vecvedant/Physical-AI-Challange/docs/report/Udyog_IQ_Project_Report.docx

ARDUINO PHYSICAL AI CHALLENGE INDIA 2026

Project Report

UDYOG IQ

Edge AI energy intelligence for small industry. One meter, one board, no cloud.

Project Title | Udyog IQ: Edge AI Energy Intelligence for Small Industry
Team Name | enter your registered team name
Registration / Team ID | enter your portal team ID
Contest Track | Industrial and Sustainability AI
Institution & City | enter your institution and city

## Team Members

Role | Name | Email
Team Leader | Vedant Charegaonkar | vec.vedant@gmail.com
Member 2 (optional)
Member 3 (optional)
Member 4 (optional)

In one sentence

A small factory has a dozen machines, one electricity connection, and a bill nobody understands. Udyog IQ puts a single energy meter on the incoming supply and an Arduino UNO Q beside it, and works out by itself, with no labelled training data, which machines are running, which one is starting to fail, how much money is being burned on idle, and when to use solar, battery or grid so the plant pays less.

# 1. Project Overview

## Problem Statement

India has millions of MSME workshops: machine shops, textile units, cold stores, small fabricators. Each runs a handful of motors on one electricity connection and receives a bill it cannot explain, because metering every machine costs more than the electricity it would save. Two large costs therefore go unmanaged. Utilities bill the highest average demand in any half hour of the month, priced per kVA, so one careless half hour where several motors start together sets a charge paid every month afterwards. Separately, compressors and pumps fail without warning even though their electrical signature had been drifting for weeks, because nobody was watching it.

## How Your Project Works

A single Selec EM2M energy meter sits on the incoming supply and is read over RS485 Modbus by the Arduino UNO Q. The STM32 microcontroller masters the bus at 1 Hz and drives a contactor behind a hardware interlock. The Qualcomm processor, running Debian, does everything else on the board.

Every time a machine switches on or off it leaves a step in real and reactive power. The node clusters those step signatures and recovers the individual machines from the aggregate, so one meter serves the whole workshop. Each machine's start events are then scored against a model of its own learned normal, which flags degradation before failure. In parallel the node forecasts plant load from its own history and solar generation from a weather feed, then solves a 24 hour battery schedule against time of day tariffs every fifteen minutes. Idle machines are cut, demand peaks are shaved before they are set, and a shadow ledger records what the same day would have cost without the device. Everything runs on the board, and a dashboard is served from it over the local network.

## Why Arduino UNO Q?

This project needs two different kinds of computer at once, and the UNO Q is one board that is both.

Brain | What it runs | Why it must be this one
STM32U585 Cortex-M33 | Modbus RTU master, contactor interlock, watchdog | RS485 has a turnaround deadline. The driver must release the line within a character time of the last stop bit or the reply collides with our own echo. Linux meets that deadline almost always, and almost means a corrupt frame every few minutes that looks exactly like a wiring fault.
Qualcomm QRB2210 quad Cortex-A53, Debian | Disaggregation, anomaly detection, forecasting, dispatch optimiser, historian, dashboard | scikit-learn, a SQLite historian, a 96 step optimisation recomputed every 15 minutes, and a web server. This is not microcontroller work.

The division also matters for safety. Minimum contactor dwell times and the switching rate cap are enforced on the microcontroller, so they hold even when the Linux side hangs, fills its disk, or is being updated. The Python policy engine checks the same rules first, but only so that it does not issue requests which would be refused. It is not the safety mechanism.

The honest version of this claim

An ESP32 could read the meter but could not run the learning half. A Raspberry Pi could run the learning half but could not promise the real time half. Using both would mean two boards, two power supplies and a link between them. One UNO Q replaces a PLC, a protocol gateway and an edge PC, and that is the specific reason this project exists on this hardware rather than being ported to it.

# 2. Components Used (BOM)

Component | Qty | Notes
Arduino UNO Q (ABX00087) | 1 | 4 GB / 32 GB variant. Qualcomm Dragonwing QRB2210 with STM32U585. Purchase proof uploaded separately.
Selec EM2M-1P-C-100A energy meter | 1 | Class 1, single phase, direct connected to 100 A with no external CT. RS485 Modbus RTU.
Isolated RS485 to UART converter | 1 | Galvanic isolation between the mains referenced meter and the board.
Relay or contactor module | 1 | Opto isolated input, sized for the controlled circuit.
5 V USB C power supply, 3 A or better | 1 | The UNO Q draws well past a phone charger's rating under load.
Screened 3 core cable, ferrules, DIN rail, enclosure | as needed | Screen earthed at one end only.
120 ohm termination resistors | 2 | Only for RS485 runs beyond a few metres.

Part number check

This template lists the UNO Q as ABX00087, while Arduino's store lists ABX00162 for the 2 GB board. Confirm against the invoice so that the BOM and the purchase proof agree.

A split core current transformer sampled at kilohertz on the STM32 ADC was considered and deliberately left out. It would have enabled genuine motor current signature analysis, but no result in this report depends on it, and the limitation is more useful stated plainly than hidden behind hardware added to make a claim sound better.

# 3. System Architecture & Circuit

## Step by Step Workflow

1. Acquire. The STM32 polls the Selec meter over RS485 at 1 Hz and caches the decoded block. Python pulls that snapshot across the Arduino Bridge and rejects it if stale, because a repeated stale frame is indistinguishable from a genuinely steady load.
2. Compensate. With the meter at the grid tie, measured solar and battery power are added back to recover the load side signal. Generation moves independently of the machines, and a cloud crossing otherwise looks exactly like a motor starting.
3. Detect. An adaptive threshold change point detector turns the power trace into discrete switching events, each carrying a signature of its step in real and reactive power.
4. Disaggregate. Those signatures are clustered online into individual machines. One meter, many machines, no labels.
5. Diagnose. Each machine's start events are scored against a density model of its own learned normal, and drift in power factor, draw and inrush is tracked separately.
6. Forecast. Plant load comes from the site's own history. Solar comes from an Open-Meteo feed through a clear sky physics model with a learned site correction.
7. Decide. Dynamic programming over discretised battery state of charge, recomputed every 15 minutes in a receding horizon control loop.
8. Act. Idle cutoff and demand shedding through the hardware interlock, in advisory mode until an operator deliberately enables actuation. In manual control every automatic policy suspends and the operator works the contactor by hand, still through the same interlock.
9. Account. A shadow ledger runs the same day with no battery movement and no idle cutoff, so the reported saving is a measured difference rather than a claim.

## Block Diagram

The whole installation, not only the controller. Power runs left to right along the top: the three sources meet at the inverter, pass through the meter, pass through the contactor, and reach the machines. The contactor really is in series there. The node sits underneath and touches the power path at exactly two points, reading the meter and commanding the contactor.


Figure 1. Udyog IQ system block diagram. Thick arrows carry power, thin dashed arrows carry signals.

## Circuit and Wiring

Signal | UNO Q pin | STM32 pin | Note
RS485 TX | D1 | PB6 | usart1 TX per the Zephyr device tree
RS485 RX | D0 | PB7 | usart1 RX
RS485 DE and RE | D2 | PB3 | Tied together. HIGH transmits.
Contactor | D7 | PB2 | Most relay boards are active low
3V3 and GND | | | Powers the isolated converter's logic side

One unresolved hardware question, handled in software

The Zephyr device tree maps the UNO Q's D0 and D1 header pins to usart1 and aliases it arduino_serial, and puts the link to the Qualcomm side on lpuart1 (pins PG5 to PG8, with hardware flow control, not brought out to the headers). At least one published tutorial states that Serial1 is reserved, which contradicts the device tree.

This is not resolvable from documentation alone, so it is a single compile time definition in the sketch, and the meter transport is a configuration key with three backends: mastered by the MCU, mastered by Linux over a USB to RS485 adapter, or simulated. Whichever way the bring up lands, it is a one line change rather than a rewrite.

## Control authority

This distinction matters more than any other in the project, so it is stated here rather than left to a limitations list. Optimising something you cannot actuate is not optimisation, it is a report.

What | Actuated? | How
Loads | Yes | A contactor in series with the machine supply, behind an interlock enforced on the microcontroller.
Sources: grid against solar and battery | Only where the inverter accepts external commands | Modbus to the inverter, on the same RS485 pair as the meter.

The node does not switch between grid and solar, deliberately

Source transfer is the inverter's job, and nearly every hybrid inverter already does it internally. Building an improvised changeover into a project like this would also be unsafe: connecting inverter output to a grid line that somebody believes is dead is the hazard that anti islanding protection exists to prevent, and a proper transfer switch is mechanically interlocked so both sources can never meet.

So the division is that the inverter moves power between sources and the node moves loads. Where the inverter exposes Modbus the node also commands its charge and discharge and the dispatch plan is enforced. Where it does not, the plan is reported and labelled as advice, and the node goes on deciding what runs and when, which it can always do.

This is not a climbdown. Across every scenario examined during development, almost all of the available saving sat in demand charge shaving, which is a load side action, and almost none in battery arbitrage, which the wear cost usually makes uneconomic in any case.

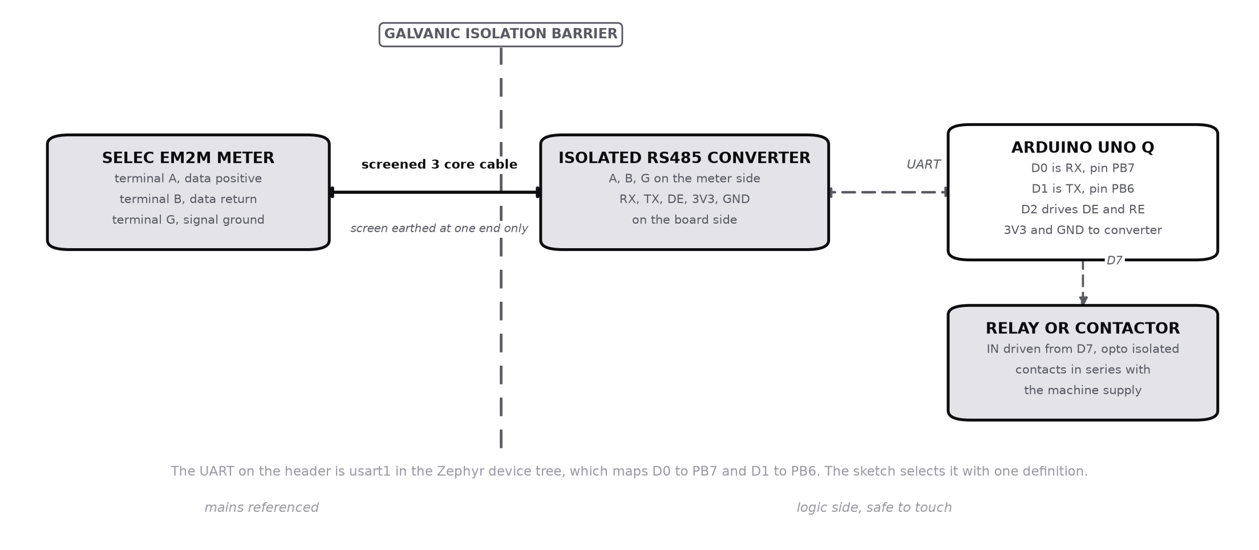
[picture p2: figure]

Figure 2. Circuit detail. The isolation barrier is the important part: the meter terminals sit at mains potential and the board does not.

[ Insert photograph of the assembled hardware: UNO Q, meter, isolated RS485 converter and contactor on DIN rail ]

# 4. AI / ML Model Details

Model Used | Five models. Online leader clustering for machine discovery; linear autoencoder (PCA reconstruction) with Isolation Forest for health; HistGradientBoostingRegressor for load and solar forecasting; dynamic programming with receding horizon control for dispatch.
Training Platform | scikit-learn, trained and retrained on the UNO Q itself from the on board SQLite historian. Nothing is trained in a cloud notebook and shipped down.
Accuracy | Not yet measured on hardware. The proof of concept bench described in section 6 is the first opportunity to quote a figure, and none is claimed until it has been taken.
Dataset | No external dataset and no pre trained weights. Every model builds its own supervision from the site's own unlabelled stream, one sample per second from the meter. Nothing is downloaded.

## How the models fit together

The organising constraint is that there is no labelled data and there never will be. Nobody is going to instrument a workshop to record which machine produced which step, and a model trained on another factory would not transfer, because the whole point is that these are this site's machines. Every model is therefore unsupervised or self supervised.

Purpose | Method | Where the labels come from
Machine discovery | Online leader clustering of switching signatures in real and reactive power | Nowhere. Machines are discovered, not classified.
Predictive maintenance | Linear autoencoder plus Isolation Forest, one per machine | Each machine's own first 80 start events define its normal.
Load forecasting | Gradient boosting, direct multi horizon | The plant's own demand a few blocks later, already in the historian.
Solar forecasting | Clear sky physics with a learned residual correction | Measured generation against the weather forecast for that hour.
Battery dispatch | Dynamic programming over discretised state of charge | Optimisation, not learning. No training involved.

## Why not XGBoost, and why not a neural network

HistGradientBoostingRegressor is the same algorithm family as XGBoost, ships inside scikit-learn, and installs on the board's aarch64 Debian without a compiler. XGBoost would have meant building from source on a 2 GHz Cortex-A53, and a dependency that will not install on the target is not a dependency, it is a bug. PyTorch and TensorFlow were excluded for the same reason, which is why the anomaly detector is a linear autoencoder rather than a neural one. Every model here retrains on the board in seconds, which is what makes on device learning practical rather than aspirational.

## Brief Description and Limitations

Disaggregation must come before diagnosis. This was not obvious and it cost a rewrite. An early health model scored the plant's aggregate feature windows and appeared to work, until it was checked against data it had not seen, where it ranked ordinary healthy operation as more anomalous than genuinely degraded operation. The ranking was inverted. An aggregate window changes far more when a different mix of machines happens to be running than it does when one machine degrades, so the model had learned the shift roster rather than the machines, and a quiet afternoon looked more alarming than a failing compressor. Health is now scored per machine, on events that disaggregation has already attributed, each of which belongs to exactly one machine.

Where this degrades or fails, stated plainly

This is not motor current signature analysis. That technique resolves sidebands around the supply frequency to identify broken rotor bars and bearing defects, and it needs current sampled in the kilohertz. At one sample per second those sidebands do not exist in our data at any resolution. What is claimed here is trend and anomaly detection on aggregate electrical parameters: a real technique, and a different one.

Disaggregation cannot see a small load hiding under a large running one. The detection threshold scales with local noise, so while a large motor runs, a small fan switching sits below the floor. This is a structural property of measuring at a single point, not a tuning failure.

Machines that switch rarely take proportionally longer to discover, because a machine only becomes knowable once it has switched often enough to form a cluster. That is the honest cost of having no labels.

Two machines that always switch together will be reported as one, and simultaneous switching produces composite clusters. The dashboard shows these as unnamed candidates for the operator to confirm or ignore, rather than asserting that they are machines.

Battery dispatch is advisory unless the inverter accepts external commands. Where it does not, the node still reports the saving it would have captured, and still performs load side actuation. The dashboard states which of the two applies rather than offering a control that quietly does nothing.

The node does not switch the plant between grid and solar. That transfer belongs to the inverter, for safety reasons as much as practical ones, and is discussed in section 3.

# 5. Code Structure

The repository is an Arduino App Lab project (app.yaml, python/, sketch/) wrapping an importable Python package, so that the models can be developed and tested away from the board.

Module | Responsibility
sketch/sketch.ino | STM32 firmware. Modbus RTU master with CRC and bus turnaround, contactor interlock (minimum dwell, switching rate cap, fail safe closed), and the Bridge RPC surface.
python/main.py | App Lab entry point on the Qualcomm side. Starts the node, handles shutdown signals so the historian flushes cleanly.
udyogiq/transport/ | Three interchangeable meter backends (bridge, serial, sim) plus inverter adapters for measured or estimated source telemetry.
udyogiq/meter/ | Selec EM2M register map, float decoding, and a physical sanity check on every frame.
udyogiq/pipeline/ | Ring buffer, windowed feature extraction, adaptive threshold change point detection.
udyogiq/ml/ | Disaggregation, health, load forecast, solar forecast, battery model.
udyogiq/policy/ | Dynamic programming dispatch optimiser, receding horizon loop, and the decision engine that issues actions with reasons.
udyogiq/sustain/ | Time of day tariff engine, weather client, carbon and counterfactual savings accounting.
udyogiq/store/ | SQLite historian with batched writes, one minute rollup and retention.
udyogiq/api/ | FastAPI and WebSocket server.
udyogiq/runtime.py | Orchestrator. One acquisition thread, everything else on a cooperative timer.
web/ | Dashboard with three views served from the board. Overview for live state, Forecast for the day ahead, and Control for the automatic and manual switch.
sim/ | Synthetic workshop with solar, battery and injectable faults.
tools/probe_meter.py | Hardware bring up. Verifies the register map against a real meter.
tests/ | 27 regression tests, each corresponding to a fault found by measurement.

## Key functions

- EdgeDetector.push() turns the power trace into confirmed switching events. Transients that return to their origin emit nothing.
- NILMEngine.push() attributes an event to a discovered machine, or founds a new cluster.
- ApplianceHealth.push_edge() scores one start event against that machine's learned normal.
- DispatchOptimiser.solve() backward induction over 96 stages, 41 states of charge and 21 actions.
- PolicyEngine.evaluate_idle() finds machines running at standby draw and cuts them, subject to the interlock.
- UdyogIQ.warmup() replays simulated history at processor speed so the node starts already knowing a plant.
- PolicyEngine.set_mode() hands control to the operator or takes it back. Switching to manual suspends every automatic policy and deliberately does not move the contactor.

GitHub Repository | https://github.com/vecvedant/Physical-AI-Challange
Demo Video Link | paste the public YouTube or Drive link

# 6. Testing & Results

## What has been tested so far

Testing to date is of the software, end to end, and of the bench build. The pipeline was exercised continuously from acquisition through disaggregation, health scoring, forecasting and dispatch to the dashboard, with the policy engine in advisory mode so that every decision was logged and none was executed.

A regression suite of 27 tests covers the parts that broke during development: register decoding and the physical sanity check that rejects a swapped word order, buffer ordering, event detection against load ripple, expiry of stale machine state, the battery charge floor, the dispatch plan never scoring worse than doing nothing, demand averaged over the billing window rather than instantaneously, advisory mode never actuating, critical loads never shed, and the interlock refusing a switch that comes too soon. Each test corresponds to a fault that was found by measurement rather than by reading the code.

No performance figures are quoted in this report

Accuracy, savings and detection rates all describe how the system behaves against real machines on a real supply, and that measurement has not been taken yet. Numbers produced during development came from a simulator written to exercise the code, and a simulator can only confirm that the software does what it was told to do. Quoting them here would describe the simulator, not the plant.

The table below is left blank deliberately. It is filled in from the bench described next, and not before.

## Proof of concept bench

The bench is the meter wired to a single phase supply feeding a motor load, with the isolated converter and the contactor as drawn in figure 2. The procedure is ordered so that each step removes a class of failure before the next step can be confused by it.

10. Verify the meter answers on RS485 and that the register map is correct. The probe tool sweeps baud rates and addresses, decides word order from physics that must hold on any single phase supply, and prints readings to check against the meter's own display. A wrong register offset does not raise an error, it returns a plausible wrong number, so this step is not optional.
11. Record a baseline with the motor switching normally, and confirm that the node discovers it as a machine and that its step size matches what the meter reports.
12. Let the health model observe enough starts to leave its learning state, then change the machine's condition, for example by loading it more heavily or restricting its airflow, and record whether and when the health score responds.
13. Compare the forecast against what the plant actually drew over the following period.
14. Exercise the contactor through the interlock: confirm minimum dwell is enforced, confirm the switching rate cap holds, and confirm the contactor returns to closed when the Linux side is stopped.
15. Check the control modes: confirm that switching to manual suspends the automatic policies without moving the contactor, that a manual switch is refused while in automatic, and that a manual request is still subject to the interlock.

## Results

To be completed from the bench above. Record what was measured, not what was expected.

Measurement | Method | Result
Meter register map verified against the display | tools/probe_meter.py
Machine discovered from the aggregate signal | run the motor, watch the dashboard
Step size reported against meter reading | compare with the meter display
Time taken for the machine to be confirmed | from first start to confirmation
Health score response to a changed condition | load or restrict the machine
Forecast error over the following period | compare against measured demand
Contactor interlock enforced | attempt a switch inside the dwell time
Contactor restored when the host is stopped | stop the application, observe
Manual control suspends the automatic policies | switch to manual, watch the log
Acquisition reliability over a continuous run | successful reads divided by attempts

## Project Images

[ Photo 1: the assembled node. UNO Q, Selec meter, isolated RS485 converter, contactor ]

[ Photo 2: the dashboard in use, showing the discovered machine and live power ]

[ Photo 3: the bench with the motor load running ]

# 7. Challenges, Learnings & Future Improvements

## Challenges Faced

- A fixed detection threshold cannot work. The first change point detector fired constantly, because a large machine under load ripples by more than a small machine draws in total. No single threshold catches a small fan switching at night without drowning during the day. The threshold is now the larger of an absolute floor and a multiple of the locally measured noise, and the noise estimate updates only on movement below threshold, so a real step cannot teach the detector to ignore steps of its own size.
- The obvious health model was inverted. Scoring the plant's aggregate windows ranked healthy operation as more anomalous than degraded operation on data the model had not seen. It had learned the shift roster rather than the machines. This forced the architecture: disaggregate first, then diagnose per machine.
- Degradation broke machine identity. As a motor wears it draws more power at worse power factor, drifts outside its own cluster tolerance, and is filed as a brand new appliance, taking its health history with it. The symptom was a machine whose event count stopped rising while replacement clusters appeared beside it. Cluster centroids now track slow drift while the health baseline stays frozen.
- Solar contaminates disaggregation at the grid tie. With the meter measuring import, a cloud crossing looks exactly like a machine switching, and a machine starting while irradiance falls registers a step of the wrong size. Generation is now added back to recover the load side signal before detection.
- Calibrating a health score took three attempts. Thresholds taken from the training data are optimistic, and left healthy machines reading as permanently unwell. Taking a high percentile from a small calibration slice is barely different from taking its maximum, so a single unusual start flattened every score afterwards. The scale is now a robust median and deviation estimate on data the model has not seen.
- A silent WebSocket rejection. The dashboard ran on its single startup fetch and never updated. The web framework resolves parameter types at runtime, the module used deferred annotations, and its imports were function local, so the socket parameter was treated as a missing query field. Found by watching the browser console, not by reading the code.

## What You Learned

The recurring lesson is that a model can look correct and be inverted, and that only measurement against something you already know the answer to will tell you the difference. Every significant fix in this project came from a number that disagreed with expectation rather than from an error message. None of those faults raised an exception. All of them would have shipped.

The second lesson is that constraints are where the design comes from. Having one meter forced disaggregation, which turned out to be the interesting part. Having no labels forced everything to be self supervised, which is what makes it deployable in a workshop nobody will ever instrument. Having to install on the board's processor ruled out the heavier libraries, which is why the models are small enough to retrain on the board itself. Having a battery with a finite cycle life is what makes doing nothing a valid and frequently correct answer.

The third is about honesty in reporting. A simulator was written to exercise the pipeline, and it was genuinely useful for finding faults. It cannot tell you how the system performs on a real supply, and this report quotes no figure from it, because a number with the wrong provenance is worse than no number at all.

# 8. Declaration

We confirm that this is our original, unpublished work. The Arduino UNO Q is the primary board in this project. All team members have reviewed and agree to this report.

We further confirm that this report quotes no performance figure that has not been measured. Results from the proof of concept bench are recorded in section 6 as they are taken, and nothing produced by the development simulator is presented as a measurement. Meter readings carry a provenance field through the whole system specifically to keep that distinction enforceable in software rather than by memory.

Date | date of submission

Arduino Physical AI Challenge India 2026 · Robu.in × Arduino · contest@robu.in
