vecvedant/Physical-AI-Challange/(commit log)

2026-08-22 Scaffold Udyog IQ project skeleton and central configuration
    Sets up the App Lab project layout (app.yaml, python/, sketch/) alongside the
    udyogiq package that holds the actual engine, so the same code is importable
    and testable off-board.
    config.py carries every tunable in one place - meter transport, feature
    windows, learning hyperparameters, tariff and battery economics, control
    policy - with config.local.json and UDYOGIQ_* environment overrides so
    site-specific wiring never lands in version control.
2026-08-22 Add Selec EM2M register map and MeterFrame sample type
    MeterFrame is the single currency the rest of the system speaks, so the
    pipeline never learns which transport produced a reading.
    The register map is the risky part of this codebase. Six offsets are confirmed
    against Selec's published parameter list; the remaining eleven are inferred
    from the documented parameter set and EM-series ordering. A wrong offset does
    not throw, it silently returns a plausible wrong number that would then be
    trained on, so each entry carries an explicit confidence level and the map is
    overridable from config. tools/probe_meter.py will verify it against a real
    unit before we trust it.
    MeterFrame.sanity_check()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
2026-08-22 Add synthetic workshop simulator with solar, battery and fault injection
    Without this the models could not be built until the RS485 was wired, and a
    bench problem on demo day would take the whole project down. The plant is
    tuned to reproduce the structure the real signal has rather than to look
    tidy: discrete switching steps with distinct P and Q signatures, motor inrush
    envelopes, jittered duty cycling, mains voltage that sags under load, and
    measurement noise.
    Two loads are deliberately close in real power - the compressor at 1500 W and
    the coolant pump at 1350 W - so that reactive power is the only thing telling
    them apart. That is the case NILM has to get right, and it would be missed b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
2026-08-22 Add pluggable meter transports: sim, serial RTU and Bridge
    Three backends behind one interface, because the same code has to run against
    a simulated plant on a laptop, a USB-RS485 dongle on any Linux box, and the
    STM32 mastering Modbus on the UNO Q. Everything above consumes MeterFrame and
    never learns which.
    That indirection is not architecture for its own sake. The docs disagree about
    whether Serial1 is free for user peripherals on the UNO Q - the Zephyr device
    tree maps the header UART to usart1 and puts the MPU router on lpuart1, but at
    least one tutorial claims otherwise - and this is not verifiable without the
    hardware in hand. Making it a config key means the answer costs one line
    ei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
2026-08-22 Add ring buffer and windowed feature extraction
    Pre-allocated numpy columns rather than a list of frames: the extractor asks
    for the last N seconds of a column many times a minute and that has to be a
    slice, not a rebuild. History is bounded because the node runs for weeks on a
    board with finite RAM.
    Windows are selected by wall time, not sample count. The poll rate is not
    guaranteed - a busy RS485 bus or a stalled MCU stretches the interval - and a
    fixed sample count would silently widen the window without anyone noticing.
    Three timescales because the phenomena live at different ones: 10 s for
    transients, 60 s for working state, 300 s for degradation drift. Nothing here
    pretends to see a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
2026-08-22 Add change-point detector with adaptive noise-scaled threshold
    Front half of NILM: turns the power trace into discrete switching events
    carrying a (dP, dQ) signature, which is close to a fingerprint because two
    motors drawing equal real power usually differ in magnetising current.
    Validated against simulator ground truth, and the first version was wrong in
    an instructive way. A fixed 25 W threshold produced 479 edges against 71 real
    switches, because a 2.2 kW lathe with 6% ripple swings +/-130 W while doing
    nothing at all. No single fixed threshold works: one low enough to catch a
    340 W fan at 02:00 drowns during the day, and one high enough for the day is
    deaf at night.
    The threshold is n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
2026-08-22 Add NILM engine: discover machines from a single meter, unlabelled
    This is the part that makes one meter enough. Switching events are clustered
    by their (dP, dQ) signature, so machines are recovered rather than metered.
    Two motors drawing equal real power usually differ in magnetising current,
    which is what makes the pair close to a fingerprint.
    Clustering, not classification, because there is no labelled data and never
    will be - nobody is going to instrument a workshop to tell us which machine
    made which step, and a model trained on another factory would not transfer.
    Leader clustering rather than DBSCAN or k-means because it is online (events
    arrive for weeks and we cannot refit over a gr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
2026-08-22 Let NILM centroids track slow drift so machines keep their identity
    A pure running mean stops moving once a cluster has hundreds of observations.
    That broke predictive maintenance in a way that took a while to see: as a motor
    degrades it draws more power at worse power factor, drifts outside its own
    cluster's tolerance, and gets filed as a brand new appliance - carrying its
    health history away with it. The symptom was the compressor's event count
    frozen at 515 while its replacement clusters appeared one after another, so the
    health monitor never saw a single degraded start.
    Flooring the centroid learning rate at 0.03 lets a confirmed cluster follow its
    machine as it ages while the health mo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
2026-08-22 Add per-appliance predictive maintenance with no labelled faults
    Scores each machine's start events against a density model of its own learned
    normal - a linear autoencoder (PCA reconstruction) plus an isolation forest,
    taking the worse of the two because they miss different things. Both pure
    scikit-learn, since torch and tensorflow have no dependable prebuilt aarch64
    wheel story and a model you cannot install is worth nothing.
    The first design scored the plant's aggregate feature windows and was wrong in
    a way that looked fine until measured: held-out healthy data scored 0.767 mean
    anomaly while genuinely degraded data scored 0.498. Inverted. The aggregate
    window moves far more when a diff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
2026-08-22 Add multi-horizon load forecasting, self-supervised on site history
    Dispatch cannot schedule a battery without knowing what the plant will draw,
    and nobody is going to label that. They do not need to: the target is the
    plant's own demand a few blocks later, so every training pair is manufactured
    from the historian by construction.
    Direct multi-horizon rather than recursive. Feeding a one-step model its own
    output compounds error, and by the 96th step of a 24-hour plan it would be
    predicting mostly from its own mistakes - which would land straight in the
    battery schedule, since dispatch weighs the far end of the horizon against the
    near end.
    HistGradientBoostingRegressor rather than XGBoost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
2026-08-22 Add time-of-day tariff engine, demand tracker and PF adjustment
    Turns kilowatt-hours into rupees, which is the only reason the dispatch
    optimiser has anything to optimise - at a flat rate there would be no point
    owning a battery.
    Windows and multipliers are configuration, not constants. The Electricity
    (Rights of Consumers) Amendment Rules made time-of-day tariffs mandatory for
    commercial and industrial consumers, but each state commission sets its own
    windows, so the defaults here are representative and must be replaced with the
    consumer's actual tariff order before any saving figure is quoted.
    Maximum demand gets its own tracker because it is billed on the *average* over
    a 15 or 30 minut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
2026-08-22 Add battery model with explicit cycle-life cost
    An optimiser told only to minimise the bill will cycle a battery as hard as the
    rate limits allow, because in that objective storage is free. It is not. Every
    kWh of throughput consumes a fraction of a finite cycle life, and on
    representative Indian LFP economics - about Rs 15,000/kWh installed, 4,000
    cycles, 75% usable depth, 90% round trip - that fraction is worth Rs 5.56/kWh.
    Which means arbitrage only pays when the tariff spread beats Rs 6.44/kWh once
    round-trip losses are included, and on the default schedule the spread is
    Rs 3.20. So the correct answer is often to do nothing, and the optimiser now
    says so.
    Leaving this term out would ha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
2026-08-22 Add DP dispatch optimiser with receding-horizon MPC
    Chooses a charge/discharge power for each of the next 96 quarter hours to
    minimise time-of-day energy cost plus demand penalty plus battery degradation,
    subject to SoC and rate limits.
    Dynamic programming rather than MILP. One continuous state, ninety-six stages:
    discretising SoC turns it into a shortest path that backward induction solves
    exactly in 4.6 ms of numpy. An MILP would return the same answer while adding a
    solver dependency that has to install and behave on aarch64, more memory, and a
    failure mode where it reports infeasible at three in the morning and the plant
    has no plan at all. This cannot fail to return a schedule, and eve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
2026-08-22 Add energy, carbon and counterfactual savings accounting
    Any device can show a kWh total. What an owner needs to know is whether the box
    on the wall paid for itself, which requires comparing what happened against
    what would have happened without it. So two worlds are integrated side by side
    from identical measured load and solar: the real one, and a shadow where the
    battery never moves and idle machines are never switched off. The difference is
    attributable, and on a day when there was nothing to gain it is zero.
    Two accounting errors found and fixed while testing, both of which would have
    put nonsense on the dashboard:
    Demand was compared on instantaneous power, but utilities bill the ave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
2026-08-22 Add policy engine for idle cutoff, demand guard and anomaly trip
    The only module here that can change the physical world, so it is written
    defensively and 'do nothing' is always an acceptable answer.
    Advisory by default. The engine reasons, explains and logs exactly what it
    would have done, and switches nothing until someone has watched it behave and
    enabled actuation deliberately. A system that starts switching machinery the
    moment it is powered up does not get a second chance in a real workshop.
    Every decision carries a sentence, not a code. An operator who finds a machine
    off must be able to read 'idle for 18 minutes, Rs 4.20 of standby burned, cut
    at 14:32' without opening a manual, be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
2026-08-22 Add SQLite historian with batched writes, rollup and retention
    SQLite because the entire premise is that nothing leaves the site. A cloud
    time-series database would be easier to build and would make the device useless
    in exactly the situation it exists for: a factory with unreliable internet and
    an owner who does not want production data on someone else's server.
    Raw samples are kept 48 hours and then folded into one-minute aggregates. Not a
    compromise - nobody inspects second-resolution power from three weeks ago, and
    everybody wants a year of daily energy, at roughly a sixtieth of the size.
    Verified at 14,400 raw samples rolling into 240 minute rows.
    Writes are batched. Committing at 1 H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
2026-08-22 Harden NILM against stale state and cluster churn over long runs
    Three faults that only showed up once the pipeline was run over a week of
    history rather than a few hours.
    A missed stop event left a machine believed to be running forever. The detector
    loses an edge whenever a small machine switches while a larger one masks it,
    and the consequence compounds: after a seven-day replay the residual sat at
    -3781 W, meaning the model thought nearly four kilowatts more was running than
    the meter could see, with runtime and energy inflated for every machine
    affected. Appliances on for far longer than they have ever run before are now
    closed out without crediting energy we cannot vouch for. Residual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
2026-08-22 Add runtime orchestrator, warm-start replay and dashboard API
    One thread owns acquisition and every estimator that must see samples in order.
    Those are stateful streaming models, and sharing them across threads would mean
    either locks in the hot path or bugs that only appear after a week of uptime.
    Everything expensive - retraining, weather, dispatch, rollup - runs on a
    cooperative timer in the same loop, because at 1 Hz there is an enormous amount
    of idle time between samples and one schedule is far easier to reason about
    than five threads contending for a single SQLite connection. No periodic task
    can take the loop down; the one thing this device must never do is stop
    measuring.
    Disaggreg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
2026-08-22 Add mobile-first PWA dashboard served from the board
    Read on a phone while standing next to a machine, so: big numbers, high
    contrast, nothing that depends on hover, and no two-handed interactions. Live
    over a WebSocket with a REST fetch on load so the page has content before the
    first push, and an exponential reconnect that never gives up - this page lives
    on a wall tablet for months.
    The four energy flows share one scale and a common zero line, so direction and
    relative magnitude read at a glance without parsing any number. The battery
    plan is drawn against a tariff strip, because a charge decision only makes
    sense next to the price that caused it.
    Three bugs found by actually running it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
    [simulated.py]
2026-08-22 Add STM32 firmware: Modbus master and contactor interlock
    The real-time half, and the reason this project needs a two-brain board.
    The MCU masters RS485 because the bus has a turnaround deadline. The
    transceiver's driver must drop within a character time of the last stop bit or
    it holds the line and the slave's reply collides with our own echo. Linux meets
    that deadline almost every time, and 'almost' produces a corrupt frame every
    few minutes that presents exactly like a wiring fault. Here the turnaround is a
    few instructions after the UART flushes.
    The MCU owns the contactor because the interlock is the actual safety
    mechanism, not a convenience. Minimum dwell, switching-rate cap and fai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
    [sketch.ino]
2026-08-22 Add hardware bring-up probe that verifies the register map
    The first thing to run against a real meter, and the reason the rest of the
    system can be trusted afterwards.
    Eleven of the seventeen register offsets are inferred rather than confirmed,
    and a wrong offset does not raise - it returns a plausible number that would be
    trained on for a fortnight before anyone noticed the compressor had gained
    400 watts. Wrong word order is the same class of failure: swap it and every
    float becomes garbage that still decodes cleanly.
    So the probe trusts nothing. It sweeps baud rates and slave ids, then decides
    the word order from physics that must hold on any single-phase supply: S
    against V*I, P again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
    [probe_meter.py]
2026-08-22 Add architecture, wiring, BOM, bring-up and assumptions docs
    The bring-up order is the important one and it is deliberate: simulator first,
    then the meter alone on a bench load, then the bus proved from Linux, then the
    numbers checked against the meter's own LCD, and only then Modbus moved onto
    the MCU. Each step removes a class of failure before the next can be confused
    by it. Flashing the sketch last means that when it breaks you already know the
    wiring and the register map are good.
    assumptions.md exists because every rupee and every kilogram this system
    reports depends on values nobody can know from here - tariff windows, battery
    capex, array geometry, the grid emission factor. They are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
2026-08-22 Add regression tests for the faults found during development
    Every test here corresponds to a bug caught by measurement rather than by
    reading code, which is the only reason to keep it: a test that has never failed
    is documentation, a test that caught something is a guard.
    Covered: float round trip and the sanity check that rejects a swapped word
    order; ring buffer ordering across a wrap and time-based rather than
    count-based windowing; edges detected with the right magnitude while transients
    emit nothing; the adaptive threshold surviving 6% ripple that produced 479
    phantom edges when it was fixed; stale on-state expiry that had driven the
    residual to -3781 W; battery SoC floor; degradation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
2026-08-22 Add the challenge project report and its generator
    Fills the official template's section structure for submission.
    Generated from tools/build_report.js rather than hand-edited, so a corrected
    number changes in one place and cannot drift out of sync with the repository
    that produced it. Regenerating is one command.
    Every quantitative claim in the report is one that was actually measured, and
    each is labelled as coming from the simulator against known ground truth. The
    limitations section is deliberately specific rather than hedged - not MCSA and
    why, small loads invisible under large ones and why, rarely-used machines taking
    longer to discover, composite clusters from simultaneous switching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
2026-08-23 Add the App Lab entry point and deployment guide
    python/main.py was missing, which meant the repository looked like an App Lab
    project but 'arduino-app run' would have done nothing on the board. It is glue
    only: everything lives in the udyogiq package one directory up, so the package
    stays importable and testable on a laptop with no Arduino tooling installed.
    It deliberately does not use App.run(). The App Lab idiom drives a user callback
    in a loop, and this project already owns its scheduling - one acquisition thread
    at a fixed cadence with retraining, dispatch and housekeeping on cooperative
    timers inside it. Handing that to an external loop driver would put two
    schedulers in disagreement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
2026-08-23 Switch the dashboard to a black and white theme
    White ground, near-black ink, four greys. Monochrome means status can no longer
    ride on hue, so it is re-encoded rather than dropped:
    online / running hollow ring vs solid ink
    machine health light chip -> darker chip -> inverted solid black. The jump
    to inverted is deliberate; an alarm should not be a
    slightly different shade of normal
    tariff windows greyscale ramp, pale when cheap and near-black at peak,
    label flipping to white as the ground darkens. This is the
    one place monochrome is an improvement - price maps to ink
    far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
2026-08-23 Add a forecast view and the API behind it
    The overview answers what is happening; nothing answered what is about to
    happen. The 24-hour plan was squeezed into one small card with no way to see
    the forecasts it was solved against, which made the optimiser's decisions
    impossible to check.
    The new view shows predicted load against expected solar with peak-tariff bands
    shaded behind them and grid draw after dispatch dashed over the top, so the
    effect of the schedule is visible rather than asserted. Alongside: the battery
    schedule with its state-of-charge trajectory, what the plan costs against doing
    nothing, per-horizon predictions with their empirical intervals, and the
    training state of every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
2026-08-23 Replace the ASCII block diagram with a real system diagram
    The previous diagram showed only the two processors talking to each other. That
    answers how the software is arranged, when the template asks for the system. A
    reader who has never seen the project could not tell from it where the
    electricity comes from, where it is measured, what it feeds, or what the node
    can actually switch.
    The new one draws the whole installation: solar array, battery and utility grid
    meeting at the hybrid inverter, through the meter, through the contactor, into
    the workshop machines, with the UNO Q underneath touching the power path at
    exactly two points. Thick arrows carry power and thin dashed arrows carry
    si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
    [build_diagram.py]
2026-08-23 Remove every unmeasured figure from the report
    The report was quoting detection rates, health scores, forecast errors and
    rupee savings that all came from the development simulator. A simulator can
    confirm that the software does what it was told to do. It cannot say how the
    system behaves against real machines on a real supply, so those numbers
    described the simulator rather than the plant, and presenting them as results
    was the wrong call.
    Section 6 now sets out the proof of concept bench instead: the meter on a single
    phase supply feeding a motor load, with the procedure ordered so each step
    removes a class of failure before the next can be confused by it. Verify the
    register map against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
2026-08-23 Drop the invented signature field from the declaration
    The template's section 8 asks for a date and nothing else. The signature row was
    mine, added on the assumption that a declaration ought to have one, which is not
    the same as the organisers requesting it. An extra field is one the entrant has
    to explain rather than one that was asked for, so it is gone.
    Checked that the only remaining occurrences of the word are the technical sense:
    electrical signature, switching signature, and motor current signature
    analysis.
2026-08-23 Rewrite the README with the system diagram and correct the stale parts
    Adds the system block diagram at the top, since a reader should be able to see
    what the installation is before reading a word about how it works, and links the
    wiring diagram alongside it.
    Three things in the old layout section were describing a repository that does
    not exist: an ml/states module that was never written, a dataset recorder and an
    offline trainer under tools/ that were never written, and a register map
    document that does not exist. python/main.py and tests/ were missing entirely.
    All checked against the working tree now, along with every link.
    Adds a project status table stating plainly that hardware has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
2026-08-23 Add manual control, and stop claiming to optimise what cannot be actuated
    The dispatch optimiser computed a battery schedule that nothing executed unless
    the inverter happened to accept commands. Calling that optimisation was wrong.
    It is a report, and the distinction is the difference between a control system
    and a spreadsheet.
    Two changes follow from that.
    First, the README now states before the feature list what the node actuates and
    what it merely advises. Loads are actuated, through a contactor behind an
    interlock. Sources are only actuated where the inverter exposes Modbus. The node
    deliberately does not switch between grid and solar itself: that is the
    inverter's job, nearly every h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
2026-08-23 Bring the report in line with the control authority reframe
    Section 3 gains a Control authority subsection stating what the node actuates
    and what it only advises, placed before anything in the document claims to
    optimise, because optimising something you cannot actuate is a report rather
    than control.
    It says plainly that the node does not switch the plant between grid and solar,
    and why: that transfer is the inverter's job, nearly every hybrid inverter
    already does it internally, and an improvised changeover risks connecting
    inverter output to a line somebody believes is dead. The inverter moves power
    between sources; the node moves loads. Also records that this is not a
    climbdown, since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
